palo399/SFuriel-Magnet-Press/docs/Podavace_koncepty.md

# Porovnanie podávačov magnetov

Tri rozvojové varianty používajú spoločnú zostavu lisu V1. Originál V1 zostáva zachovaný. Náhľad Porovnanie.png zobrazuje len detail mechanizmov bez rámu a dlhej rúrky, aby bol výstup viditeľný. STEP obsahuje aj rám a 300 mm zásobník.

Všetky varianty: predpokladaný magnet Ø14 × 3 mm; odber pod zásobníkom X=65, lis X=0; magnet v polohe odovzdania je v Z=17..20. Hlava musí magnet prevziať a zdvihnúť pred návratom podávača. Až potom môže lisovať. Geometria je koncepčná, bez overenia síl, plného cyklu a výrobných tolerancií.

## A – lineárny posúvač s kapsou (odporúčaný)
Zásobník plní slepú kapsu. Posúvač ide 65 mm k hlave. Jeho plná časť medzitým podopiera stĺpec; pevná stieracia doska nad posúvačom nepustí druhý magnet do dráhy. Magnet sa odoberá zhora, nad kapsou nie je pevný kryt. Model ukazuje kapsu pri hlave. Potrebné doladiť medzeru pod rúrkou podľa skutočnej hrúbky magnetu a silu oddeľovania. Jeden posuvný pohon.

## B – otočný kotúč s dvoma kapsami
Dve slepé kapsy sú proti sebe, os kotúča je X=32,5. Otočenie 180° prenesie magnet k hlave; druhá kapsa sa plní pod zásobníkom. Pevná doska pri zásobníku oddeľuje ďalší magnet. Väčší pôdorys, rotačný pohon s presným indexovaním. Potrebné preveriť okolie vodiacej lišty a rámu počas rotácie.

## C – otvorená vidlička so samostatnou uzávierkou
Vidlička nesie magnet v otvorenej kapse. Nezávislá tenká uzávierka drží zvyšok stĺpca počas odberu. Rúrka má štrbinu pre uzávierku. Dva riadené pohyby; treba dopracovať pridržiavanie stĺpca pri zasunutí uzávierky a preukázať jej zasunutie medzi magnety. Tento variant má najväčšie riziko komplikácií pri magnetickej príťažlivosti, preto je rezervný.

## Čo je a nie je overené
Overená platná geometria dielov a spätný import všetkých troch STEP zostáv. Nie je overená bezkolíznosť celého cyklu ani spoľahlivé oddelenie magnetov. Pohony a zvyšok lisu sú zatiaľ obálky z V1. Pred výrobou treba potvrdiť rozmery, polaritu a povrch magnetu, zvoliť nemagnetické materiály podávača a vyskúšať oddeľovanie reálneho stĺpca. Náhľady sú statické výkresy odvodené z CAD, nie simulácia pohybu.
