palo399/SFuriel-Magnet-Press/models/concept-C4/Mounting_holes_C4.csv

Part | Assembly_X | Assembly_Y | Diameter | Units
Base | 0 | 0 | 8 | mm
Base | -85 | -42.5 | 13 | mm
Base | 85 | -42.5 | 13 | mm
Base | -22 | 155 | 5 | mm
Base | -22 | 193 | 5 | mm
Base | 22 | 155 | 5 | mm
Base | 22 | 193 | 5 | mm
Base | 180 | -20 | 5 | mm
Base | 180 | 20 | 5 | mm
Base | 290 | -20 | 5 | mm
Base | 290 | 20 | 5 | mm
Base | -19 | -100 | 6.6 | mm
Base | -19 | 50 | 6.6 | mm
Base | 19 | -100 | 6.6 | mm
Base | 19 | 50 | 6.6 | mm
Base | -130 | -140 | 9 | mm
Base | -130 | 230 | 9 | mm
Base | 340 | -140 | 9 | mm
Base | 340 | 230 | 9 | mm
Bridge | -85 | -42.5 | 13 | mm
Bridge | 85 | -42.5 | 13 | mm
Bridge | 0 | 0 | 20 | mm
Bridge | 65 | 0 | 20.5 | mm
Bridge | -23.25 | -23.25 | 9 | mm
Bridge | -23.25 | 23.25 | 9 | mm
Bridge | 23.25 | -23.25 | 9 | mm
Bridge | 23.25 | 23.25 | 9 | mm
Bridge | 52 | -13 | 4.5 | mm
Bridge | 52 | 13 | 4.5 | mm
Bridge | 78 | -13 | 4.5 | mm
Bridge | 78 | 13 | 4.5 | mm
