palo399/SFuriel-Magnet-Press/models/concept-C2/Track_C2.png

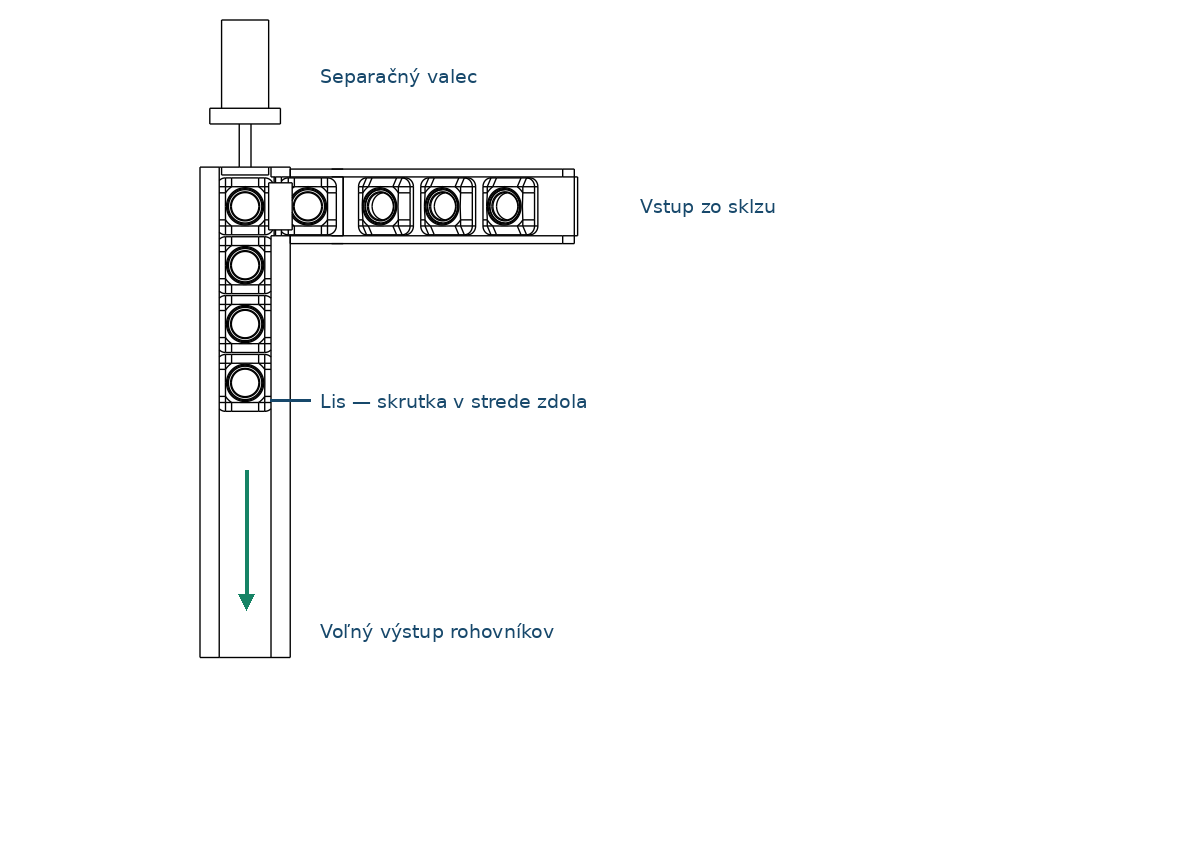
models/concept-C2/Track_C2.png
