palo399/SFuriel-Magnet-Press/models/concept-C4/Plan_C4.png

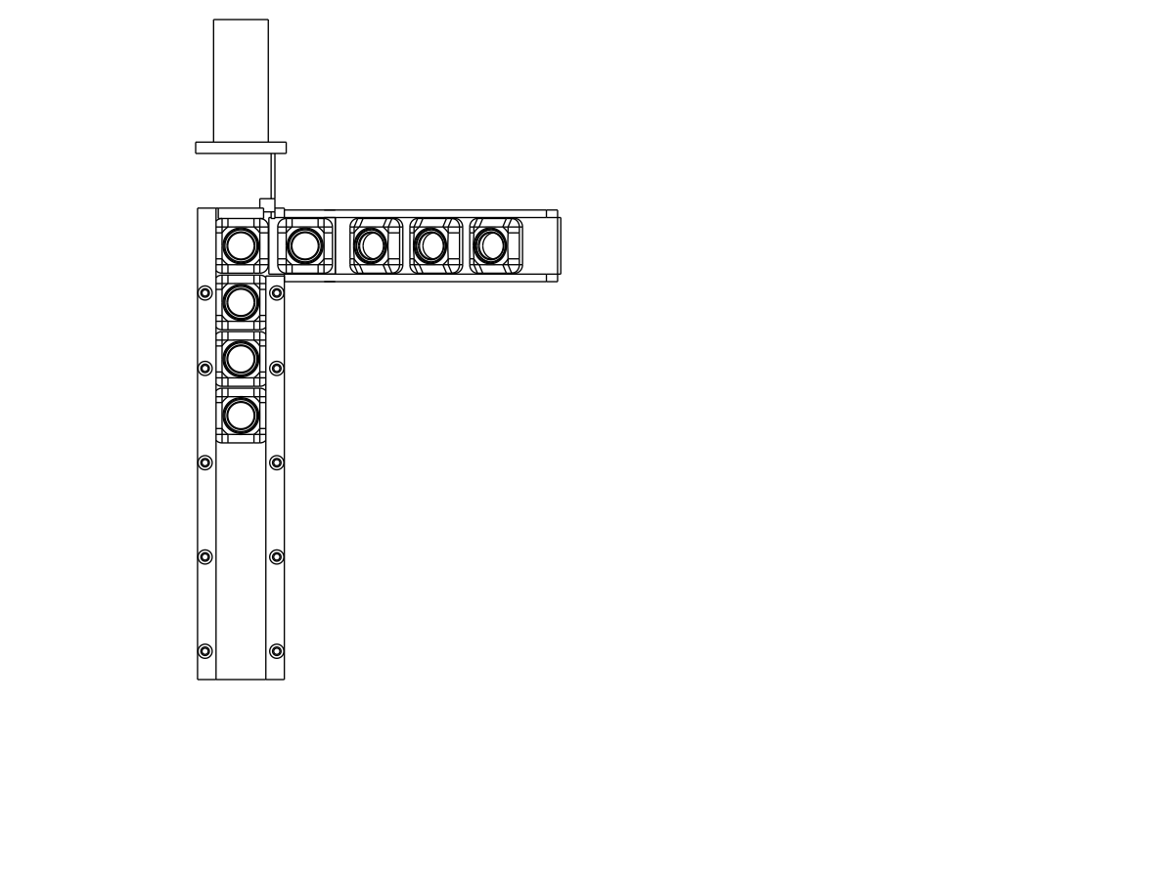
models/concept-C4/Plan_C4.png
