palo399/SFuriel-Magnet-Press/models/feeder-concepts/A_linear.png

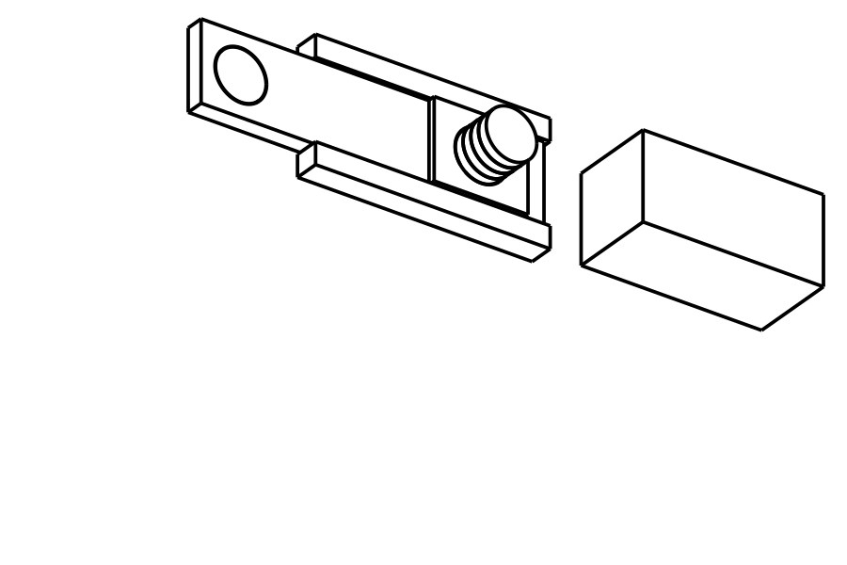
models/feeder-concepts/A_linear.png
