palo399/SFuriel-Magnet-Press/models/feeder-concepts/B_rotary.png

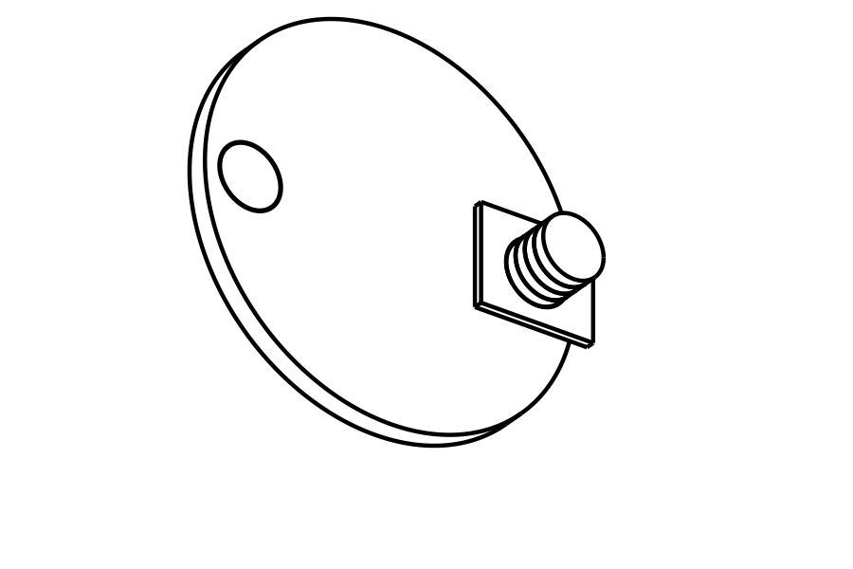
models/feeder-concepts/B_rotary.png
