palo399/SFuriel-Magnet-Press/models/feeder-concepts/C_fork.png

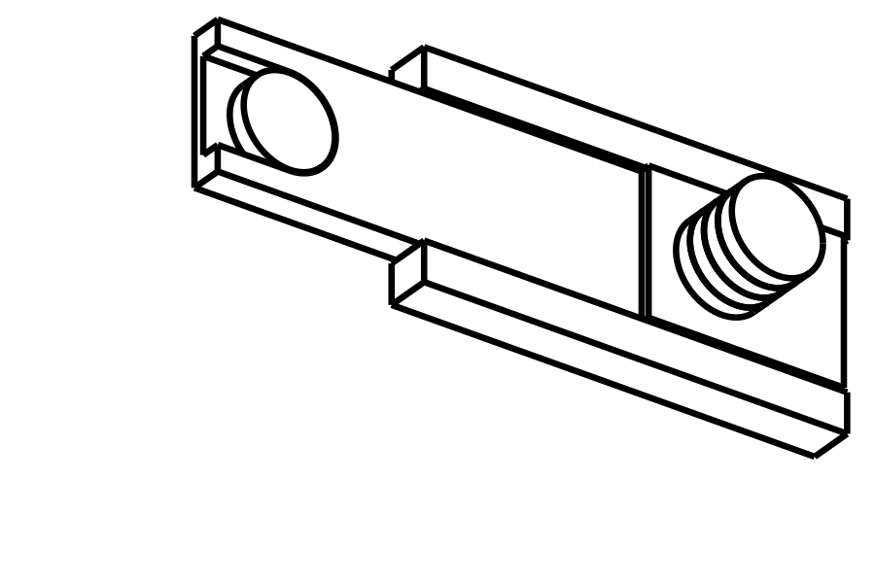
models/feeder-concepts/C_fork.png
