palo399/SFuriel-Magnet-Press/models/feeder-concepts/Porovnanie.png

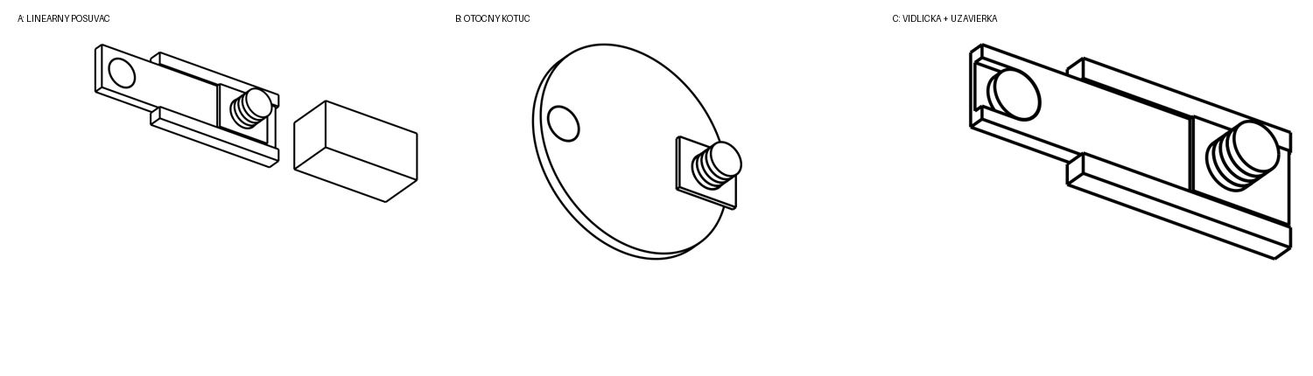
models/feeder-concepts/Porovnanie.png
