palo399/SFuriel-Magnet-Press/models/concept-C2/C_fork.step

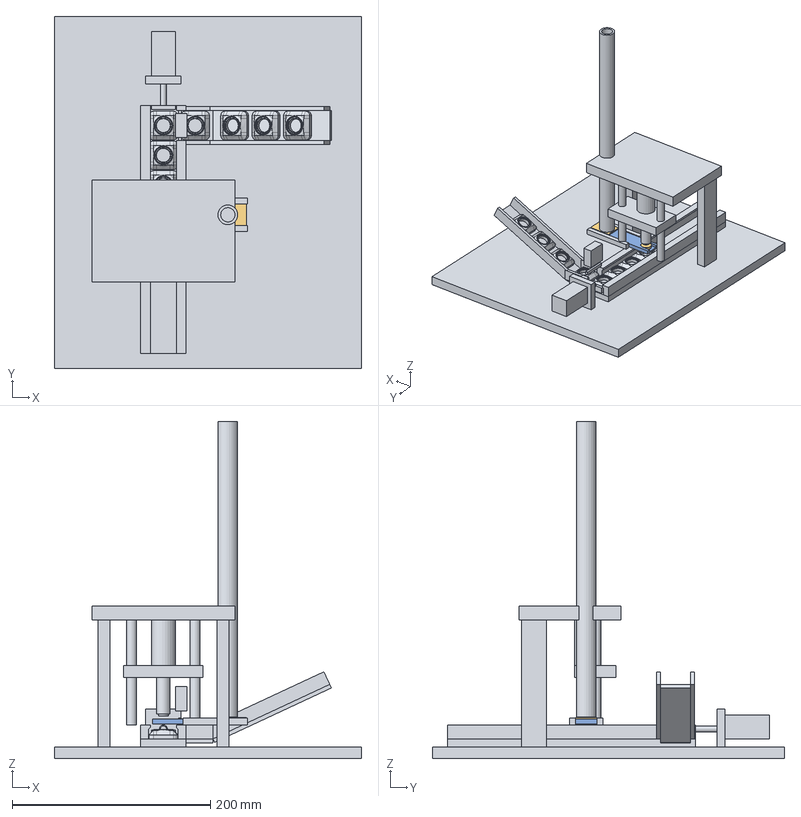
[picture p8: CAD file, 2026-10-31]
models/concept-C2/C_fork.step
310.0 x 355.0 x 340.2 mm
Guide_post_-32
Guide_post_32
Moving_crosshead
Press_ram_envelope
Press_punch
Head_pickup_magnet
Workpiece_at_press_C2
M6_vertical_plunger_body_envelope
Plunger_ball_concept
Base_C2
Side_frame_column_-66
Side_frame_column_54
Top_bridge_C2
Through_track_bed
Left_through_retaining_rail
Right_through_retaining_rail
L_inlet_level_bed
L_inlet_level_side_71
L_inlet_level_side_105
Chute_bed
Chute_wall_front
Chute_wall_back
Queue_on_track_0
Queue_on_track_1
Queue_on_track_2
Part_at_lateral_inlet
Part_on_inlet_slope_0
Part_on_inlet_slope_1
Part_on_inlet_slope_2
Separator_cylinder_body_envelope
Separator_cylinder_mount
Separator_rod_retracted
Separator_pusher_retracted
Inlet_gate_blade_open
Inlet_gate_actuator_envelope
Pickup_magnet
Open_fork
Independent_stack_gate_closed
Tube_with_gate_slot
Fork_guide_-17
Fork_guide_11
Stack_magnet_0
Stack_magnet_1
Stack_magnet_2
Stack_magnet_3
