palo399/SFuriel-Magnet-Press/models/concept-C3/plates/P08_Mast_shelf_50.step

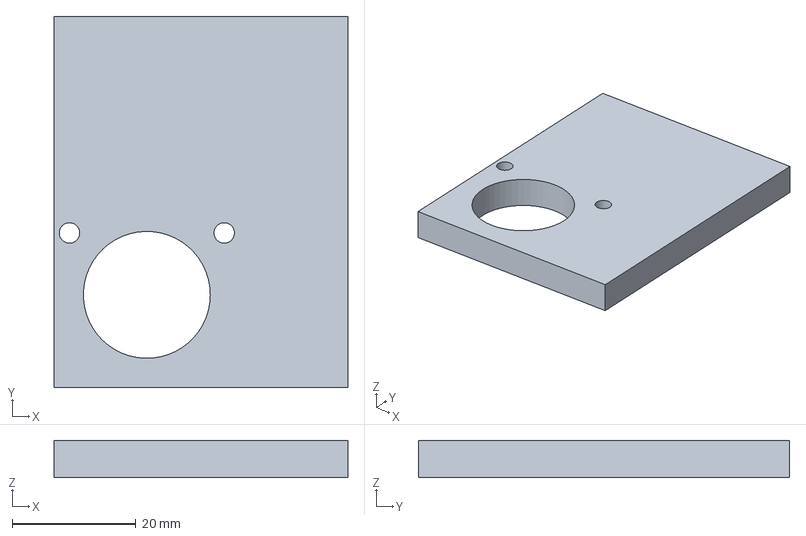
[picture p9: CAD file, 2026-10-31]
models/concept-C3/plates/P08_Mast_shelf_50.step
47.5 x 60.0 x 6.00 mm
