palo399/SFuriel-Magnet-Press/models/concept-C3/Rohovnik_press_C3_Bosch_Festo.step

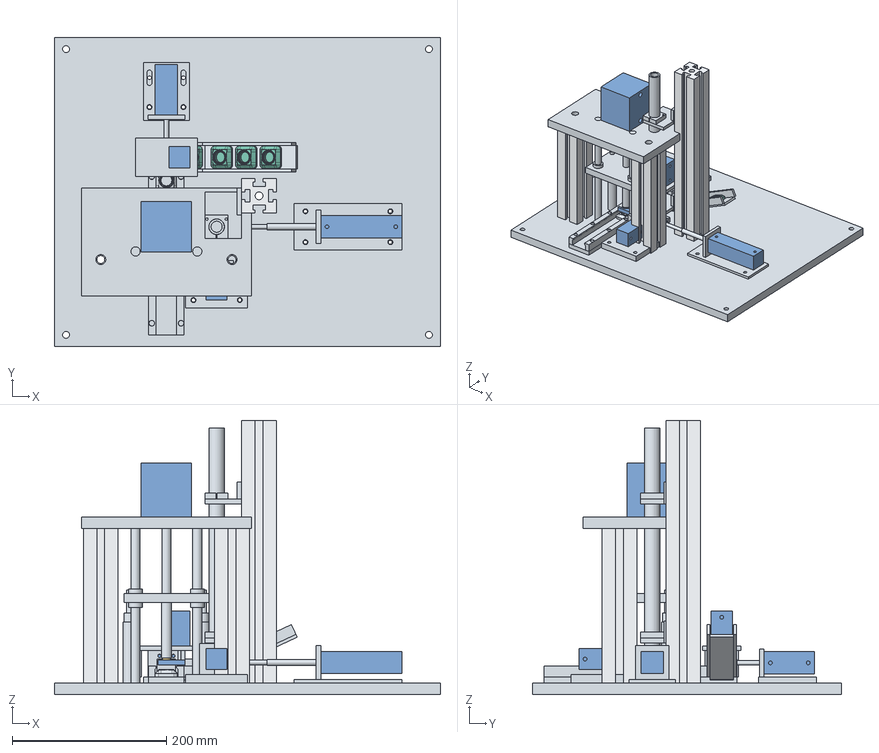
[picture p10: CAD file, 2026-10-31]
models/concept-C3/Rohovnik_press_C3_Bosch_Festo.step
500.0 x 400.0 x 355.0 mm
Workpiece_at_press_C2
M6_vertical_plunger_body_envelope
Plunger_ball_concept
L_inlet_level_bed
L_inlet_level_side_71
L_inlet_level_side_105
Chute_bed
Chute_wall_front
Chute_wall_back
Queue_on_track_0
Queue_on_track_1
Queue_on_track_2
Part_at_lateral_inlet
Part_on_inlet_slope_0
Part_on_inlet_slope_1
Part_on_inlet_slope_2
P01_Base
P02_Track_bed
M4x16_Left_-125
M4x16_Left_-75
M4x16_Left_-25
M4x16_Left_25
M4x16_Left_65
Left_through_retaining_rail
M4x16_Righ_-125
M4x16_Righ_-75
M4x16_Righ_-25
M4x16_Righ_25
M4x16_Righ_65
Right_through_retaining_rail
BR_Left_column
BR_Right_column
BR_Magazine_mast
P03_Top_bridge
P04_Moving_head
Guide_D12_-40
Guide_bushing_-40
Guide_D12_40
Guide_bushing_40
Punch_shaft
Head_pickup_magnet
Product_magnet_14x5
Stop_support_-48
Adjustable_stop_M8_-48
Stop_support_48
Adjustable_stop_M8_48
Festo_PRESS_ADN50_25
Press_rod_adapter
Festo_PART_INDEX_ADN16_30
P05_Separator_face
Separator_rod_extension
Separator_pusher
P06_Separator_foot
C_fork_14x5
Fork_slide_guide_-17
Fork_slide_guide_11
Festo_FORK_ADN16_70
P07_Fork_motor_face
Fork_link_extension
Fork_extended_rod_65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
