palo399/SFuriel-Magnet-Press/models/concept-C4/C4_Bridge.step

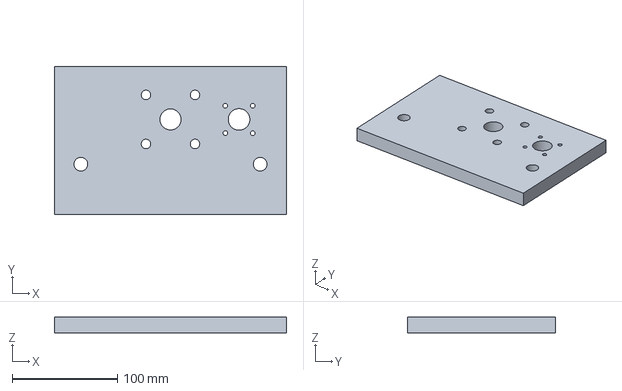
[picture p11: CAD file, 2026-10-31]
models/concept-C4/C4_Bridge.step
220.0 x 140.0 x 15.0 mm
