palo399/SFuriel-Magnet-Press/models/feeder-concepts/C_fork.step

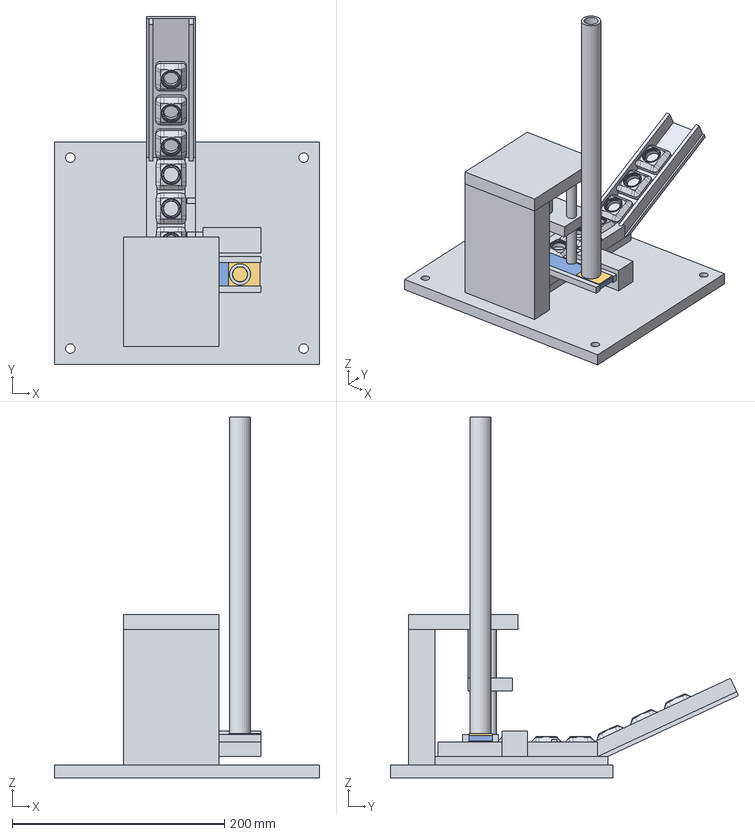
[picture p13: CAD file, 2026-10-31]
models/feeder-concepts/C_fork.step
250.0 x 328.1 x 340.2 mm
Base_plate
Track_support
Workpiece_at_press
Left_retaining_bevel_rail
Right_retaining_bevel_rail
Gravity_chute_25deg
Chute_side_L
Chute_side_R
Queued_part_1
Queued_part_2
Queued_part_3
Chute_part_1
Chute_part_2
Chute_part_3
Part_index_cylinder_envelope
Part_index_slide
Escapement_stop_35
Escapement_stop_67
Station_end_stop
M6_ball_plunger_envelope
Plunger_ball
Rear_column
Top_crossmember
Guide_post_-32
Guide_post_32
Moving_crosshead
Press_ram_envelope
Press_punch
Head_pickup_magnet
Pickup_magnet
Open_fork
Independent_stack_gate_closed
Tube_with_gate_slot
Fork_guide_-17
Fork_guide_11
Stack_magnet_0
Stack_magnet_1
Stack_magnet_2
Stack_magnet_3
