palo399/SFuriel-Magnet-Press/models/manufacturing-C5/parts/D10_Fixed_stripper.step

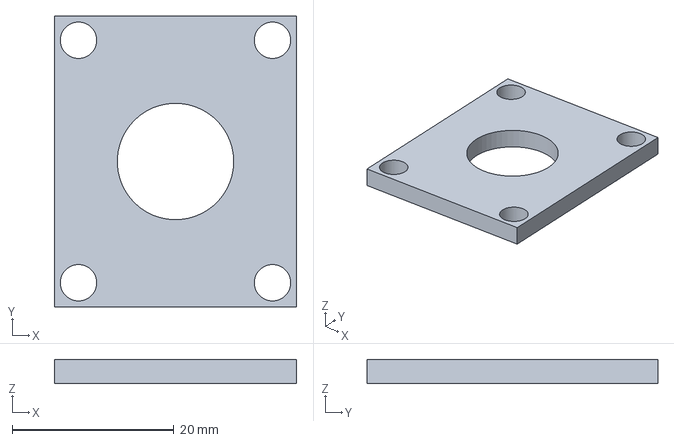
[picture p14: CAD file, 2026-10-31]
models/manufacturing-C5/parts/D10_Fixed_stripper.step
30.0 x 36.0 x 3.00 mm
