palo399/SFuriel-Magnet-Press/models/manufacturing-C5/Rohovnik_press_C5_prototype_DRAFT.step

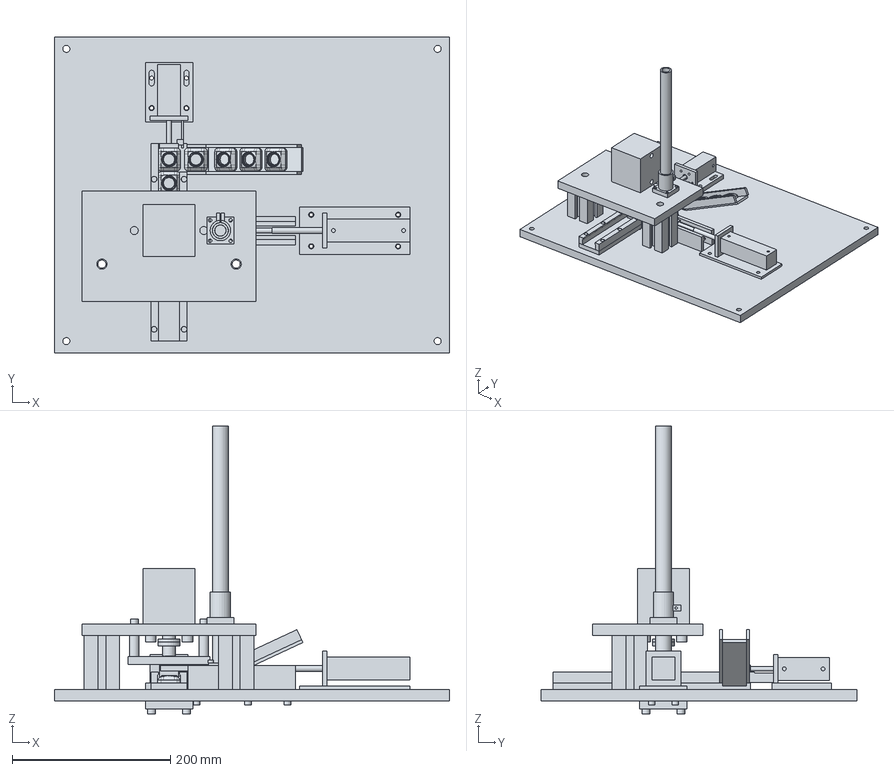
[picture p15: CAD file, 2026-10-31]
models/manufacturing-C5/Rohovnik_press_C5_prototype_DRAFT.step
500.0 x 400.0 x 364.2 mm
Workpiece_at_press_C2
L_inlet_level_bed
L_inlet_level_side_71
L_inlet_level_side_105
Chute_bed
Chute_wall_front
Chute_wall_back
Queue_on_track_0
Queue_on_track_1
Queue_on_track_2
Part_on_inlet_slope_0
Part_on_inlet_slope_1
Part_on_inlet_slope_2
M4x16_Left_-125
M4x16_Left_-75
M4x16_Left_-25
M4x16_Left_25
M4x16_Left_65
Left_through_retaining_rail
M4x16_Righ_-125
M4x16_Righ_-75
M4x16_Righ_-25
M4x16_Righ_25
M4x16_Righ_65
Right_through_retaining_rail
Head_pickup_magnet
Product_magnet_14x5
Festo_PART_INDEX_ADN16_30
P05_Separator_face
Separator_rod_extension
P06_Separator_foot
Festo_FORK_ADN16_70
P07_Fork_motor_face
Fork_link_extension
Fork_extended_rod_65
P09_Fork_motor_foot
Next_rohovnik_on_inlet
BR_Left_column_L68
BR_Right_column_L68
Festo_PRESS_ADN50_25
Magnet_tube_300
Stack_14x5_0
Stack_14x5_1
Stack_14x5_2
Stack_14x5_3
Linked_pusher_and_inlet_shutter
KIPP_K0309_212_ORIGINAL
D01_Base
D02_Track_bed
D03_Plunger_block
D04_Bridge
D05_Stop_plate
D06_Stop_spacer_-44
D06_Stop_spacer_44
D07_Press_tool
D08_Adjust_ring
D09_Lock_ring
D10_Fixed_stripper
D11_Carrier_support_-18
D11_Carrier_support_12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
