palo399/SFuriel-Magnet-Press/models/Rohovnik magnet.stp

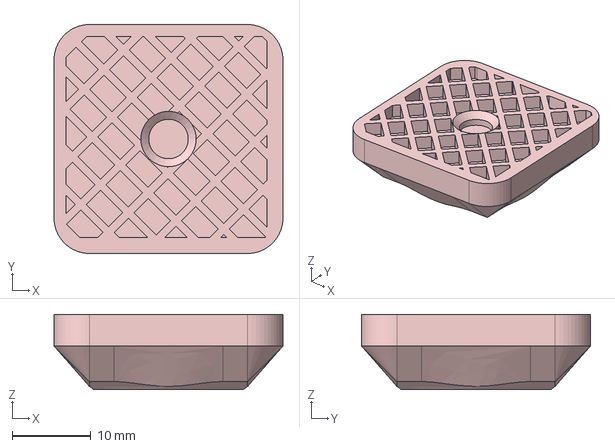
[picture p16: CAD file, 2026-10-31]
models/Rohovnik magnet.stp
29.0 x 29.0 x 9.50 mm
