palo399/SFuriel-Magnet-Press/models/concept-C3/plates/Right_through_retaining_rail.step

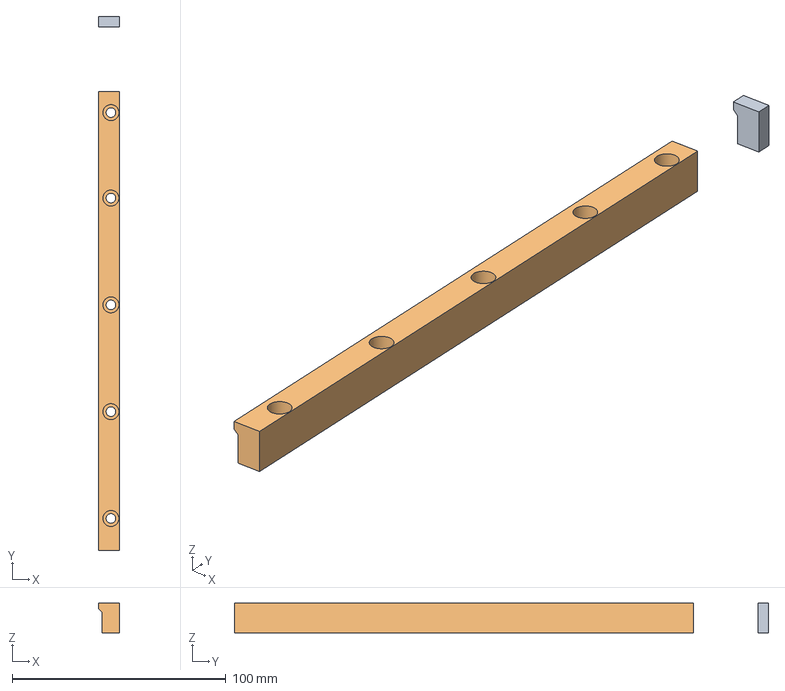
[picture p17: CAD file, 2026-10-31]
models/concept-C3/plates/Right_through_retaining_rail.step
9.80 x 250.0 x 14.0 mm
