palo399/SFuriel-Magnet-Press/models/concept-C4/Fixed_magnet_stripper.step

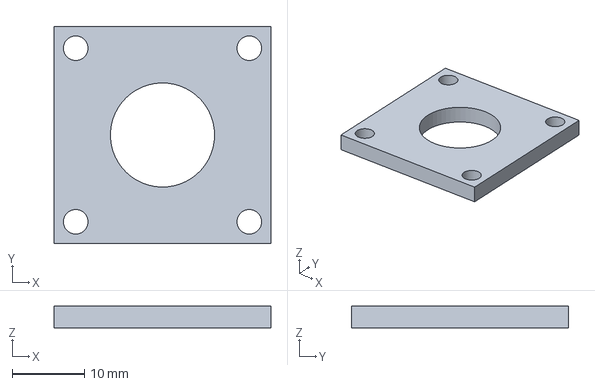
[picture p18: CAD file, 2026-10-31]
models/concept-C4/Fixed_magnet_stripper.step
30.0 x 30.0 x 3.00 mm
