palo399/SFuriel-Magnet-Press/models/manufacturing-C5/parts/D12_Carrier_14x5.step

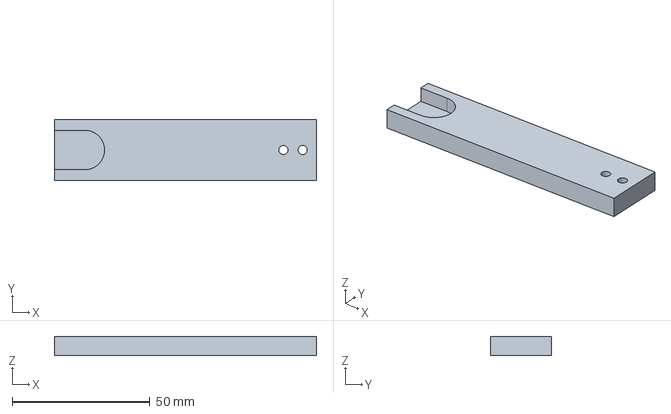
[picture p19: CAD file, 2026-10-31]
models/manufacturing-C5/parts/D12_Carrier_14x5.step
95.0 x 22.0 x 7.00 mm
