palo399/SFuriel-Magnet-Press/models/concept-C3/plates/P04_Moving_head.step

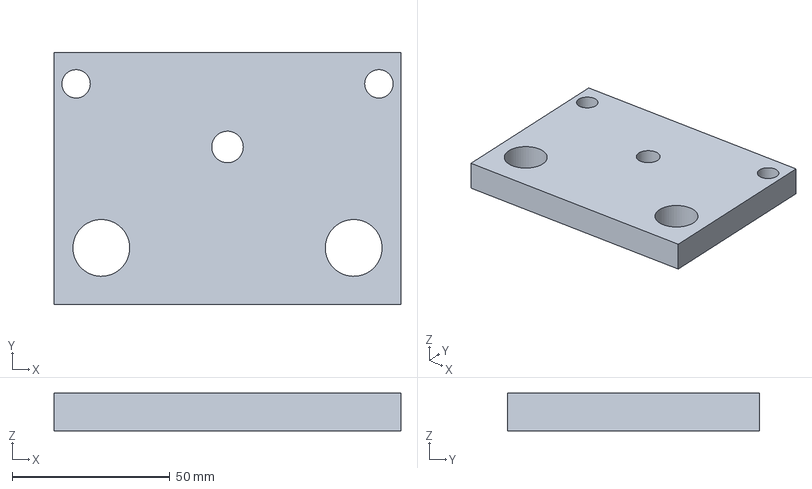
[picture p20: CAD file, 2026-10-31]
models/concept-C3/plates/P04_Moving_head.step
110.0 x 80.0 x 12.0 mm
