palo399/SFuriel-Magnet-Press/models/concept-C4/Rohovnik_press_C4_simple.step

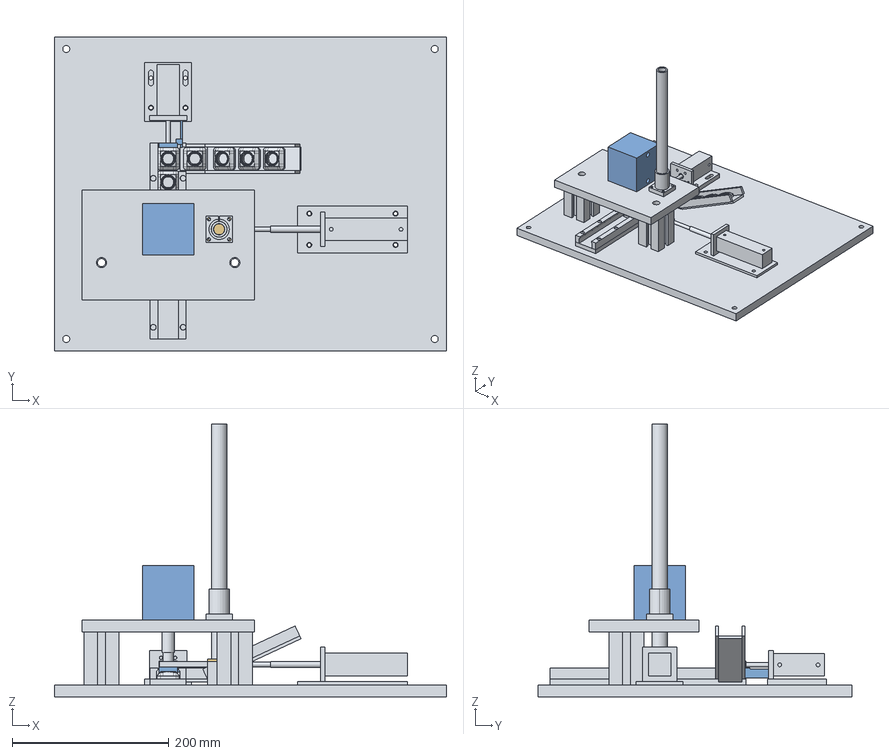
[picture p21: CAD file, 2026-10-31]
models/concept-C4/Rohovnik_press_C4_simple.step
500.0 x 400.0 x 348.2 mm
Workpiece_at_press_C2
M6_vertical_plunger_body_envelope
Plunger_ball_concept
L_inlet_level_bed
L_inlet_level_side_71
L_inlet_level_side_105
Chute_bed
Chute_wall_front
Chute_wall_back
Queue_on_track_0
Queue_on_track_1
Queue_on_track_2
Part_on_inlet_slope_0
Part_on_inlet_slope_1
Part_on_inlet_slope_2
P02_Track_bed
M4x16_Left_-125
M4x16_Left_-75
M4x16_Left_-25
M4x16_Left_25
M4x16_Left_65
Left_through_retaining_rail
M4x16_Righ_-125
M4x16_Righ_-75
M4x16_Righ_-25
M4x16_Righ_25
M4x16_Righ_65
Right_through_retaining_rail
Head_pickup_magnet
Product_magnet_14x5
Festo_PART_INDEX_ADN16_30
P05_Separator_face
Separator_rod_extension
P06_Separator_foot
C_fork_14x5
Festo_FORK_ADN16_70
P07_Fork_motor_face
Fork_link_extension
Fork_extended_rod_65
Fork_coupling_block
P09_Fork_motor_foot
Next_rohovnik_on_inlet
C4_Base_plate
BR_Left_column_L68
BR_Right_column_L68
C4_Bridge
Festo_PRESS_ADN50_25
Short_coaxial_press_tool
Fixed_magnet_stripper
Stripper_side_support_-15
Stripper_side_support_12
Magnet_tube_300
Tube_split_collar_on_bridge
Stack_14x5_0
Stack_14x5_1
Stack_14x5_2
Stack_14x5_3
Linked_pusher_and_inlet_shutter
