palo399/SFuriel-Magnet-Press/models/manufacturing-C5/parts/D14_Tube_collar.step

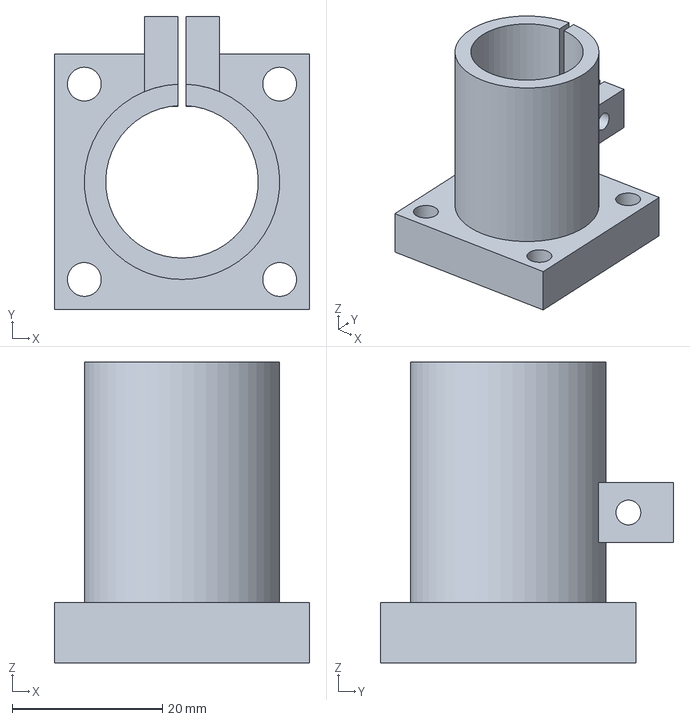
[picture p23: CAD file, 2026-10-31]
models/manufacturing-C5/parts/D14_Tube_collar.step
34.0 x 39.0 x 40.0 mm
