palo399/SFuriel-Magnet-Press/models/concept-C3/plates/P02_Track_bed.step

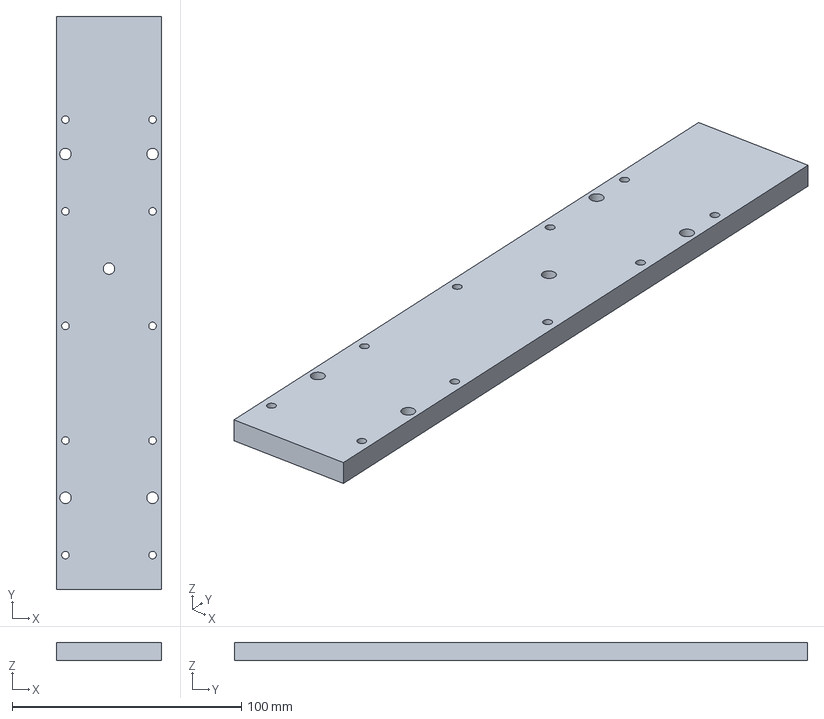
[picture p24: CAD file, 2026-10-31]
models/concept-C3/plates/P02_Track_bed.step
46.0 x 250.0 x 8.00 mm
