palo399/SFuriel-Magnet-Press/models/concept-C4/Linked_pusher_and_inlet_shutter.step

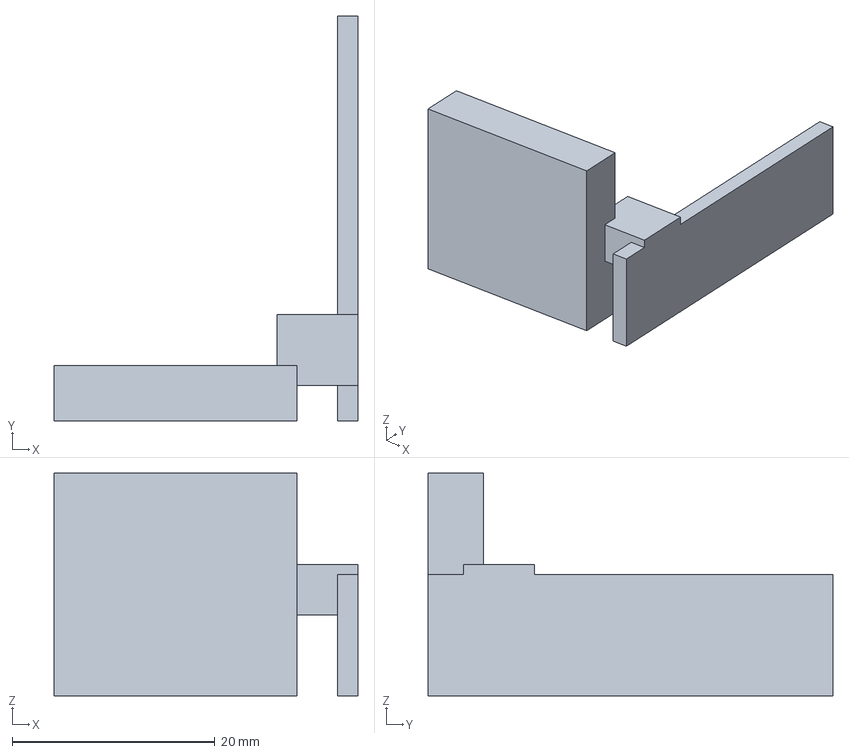
[picture p25: CAD file, 2026-10-31]
models/concept-C4/Linked_pusher_and_inlet_shutter.step
30.0 x 40.0 x 22.0 mm
