palo399/SFuriel-Magnet-Press/models/manufacturing-C5/parts/D11_Carrier_support_12.step

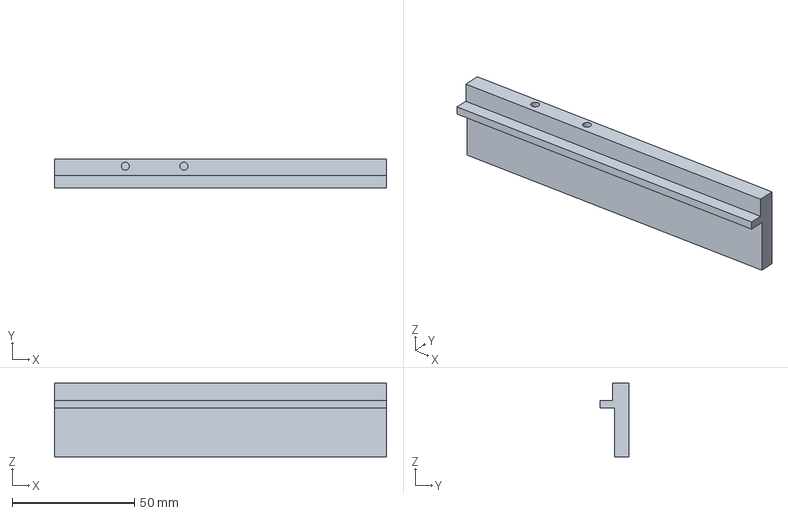
[picture p26: CAD file, 2026-10-31]
models/manufacturing-C5/parts/D11_Carrier_support_12.step
136.0 x 12.0 x 30.2 mm
