palo399/SFuriel-Magnet-Press/models/concept-C3/plates/P09_Fork_motor_foot.step

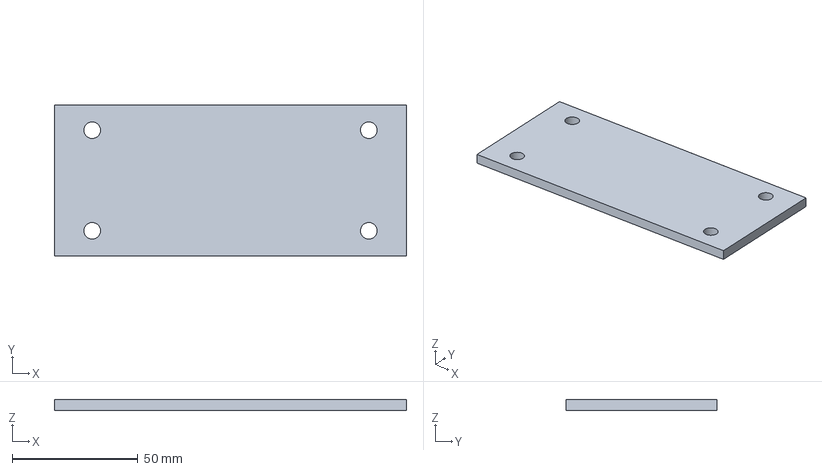
[picture p27: CAD file, 2026-10-31]
models/concept-C3/plates/P09_Fork_motor_foot.step
140.0 x 60.0 x 4.50 mm
