palo399/SFuriel-Magnet-Press/models/concept-C4/Short_coaxial_press_tool.step

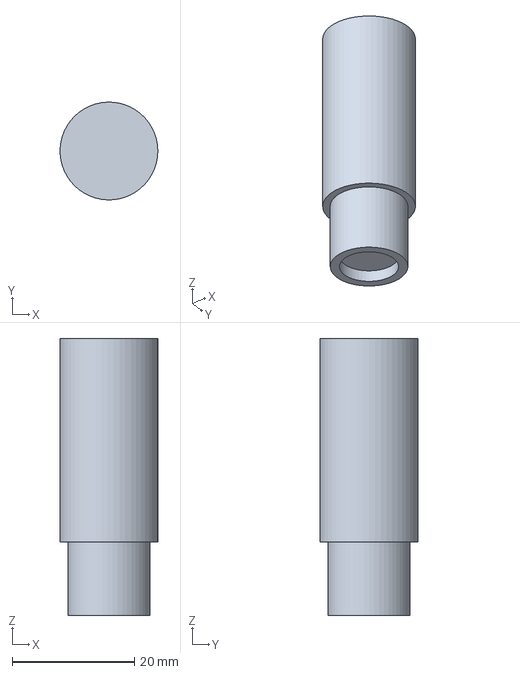
[picture p28: CAD file, 2026-10-31]
models/concept-C4/Short_coaxial_press_tool.step
16.0 x 16.0 x 45.3 mm
