palo399/SFuriel-Magnet-Press/models/manufacturing-C5/parts/D05_Stop_plate.step

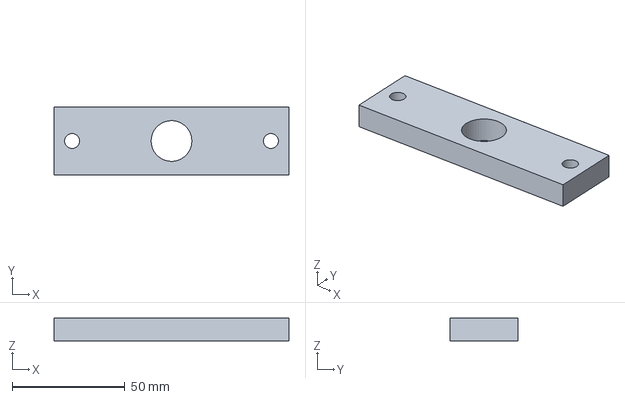
[picture p29: CAD file, 2026-10-31]
models/manufacturing-C5/parts/D05_Stop_plate.step
104.0 x 30.0 x 10.0 mm
