palo399/SFuriel-Magnet-Press/models/concept-C3/plates/P11_Inlet_gate_motor_shelf.step

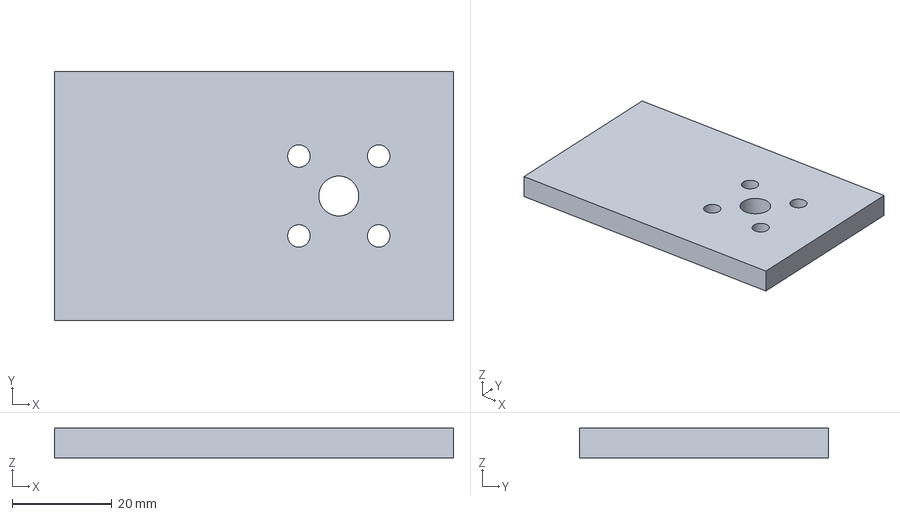
[picture p30: CAD file, 2026-10-31]
models/concept-C3/plates/P11_Inlet_gate_motor_shelf.step
80.0 x 50.0 x 6.00 mm
