palo399/SFuriel-Magnet-Press/models/concept-C4/Tube_split_collar_on_bridge.step

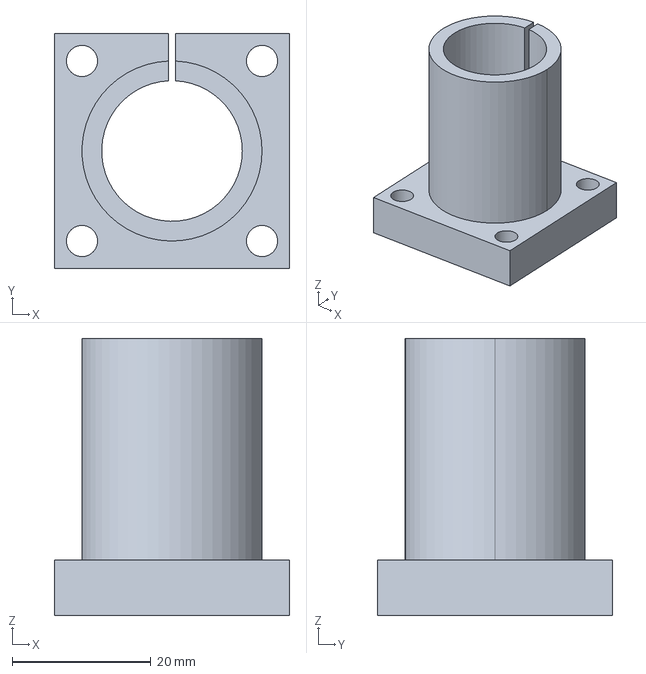
[picture p31: CAD file, 2026-10-31]
models/concept-C4/Tube_split_collar_on_bridge.step
34.0 x 34.0 x 40.0 mm
