palo399/SFuriel-Magnet-Press/models/manufacturing-C5/parts/D07_Press_tool.step

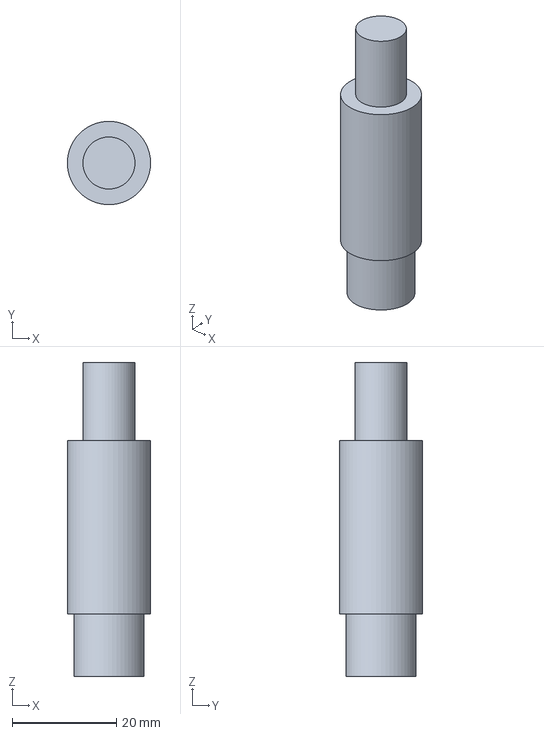
[picture p32: CAD file, 2026-10-31]
models/manufacturing-C5/parts/D07_Press_tool.step
16.0 x 16.0 x 60.3 mm
