palo399/SFuriel-Magnet-Press/models/concept-C3/plates/Left_through_retaining_rail.step

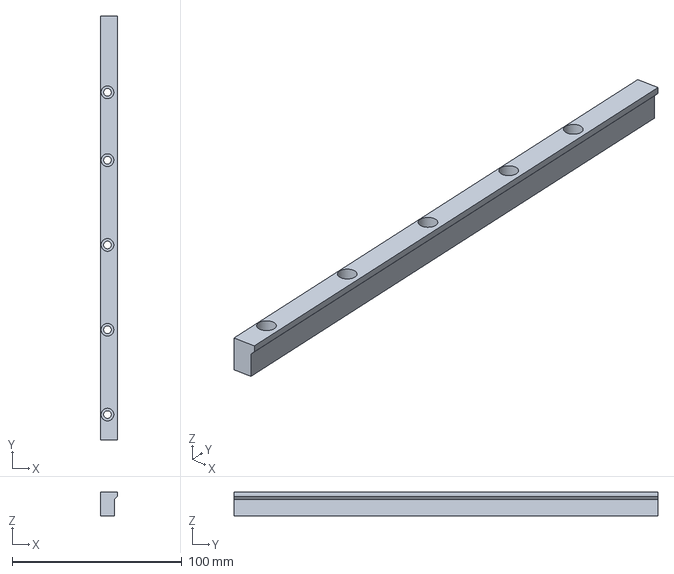
[picture p33: CAD file, 2026-10-31]
models/concept-C3/plates/Left_through_retaining_rail.step
9.80 x 250.0 x 14.0 mm
