palo399/SFuriel-Magnet-Press/models/concept-C4/C4_Base_plate.step

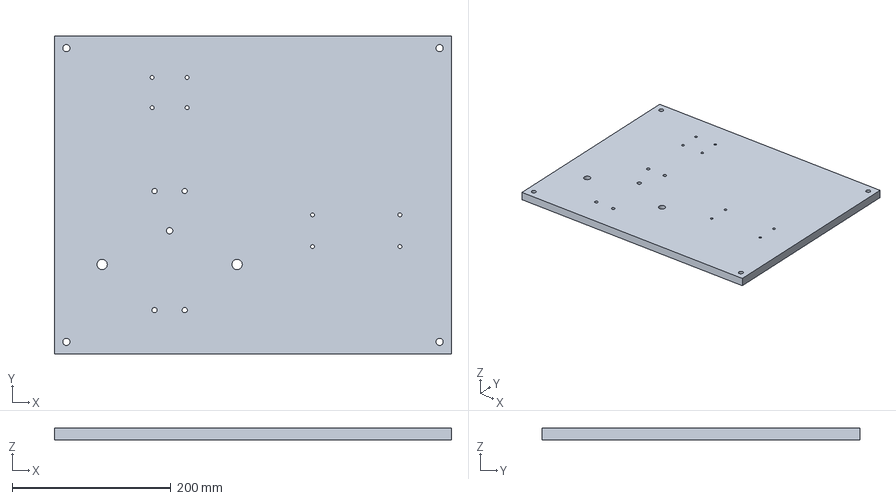
[picture p34: CAD file, 2026-10-31]
models/concept-C4/C4_Base_plate.step
500.0 x 400.0 x 15.0 mm
