palo399/SFuriel-Magnet-Press/models/concept-C3/plates/P03_Top_bridge.step

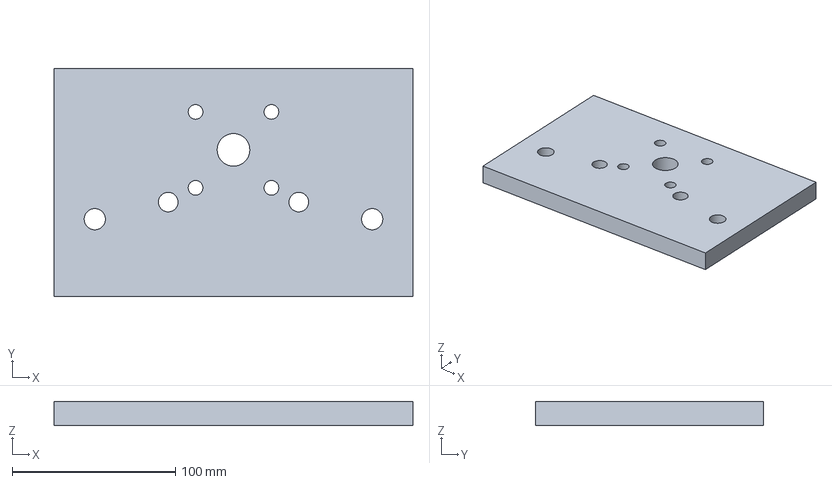
[picture p35: CAD file, 2026-10-31]
models/concept-C3/plates/P03_Top_bridge.step
220.0 x 140.0 x 15.0 mm
