palo399/SFuriel-Magnet-Press/models/manufacturing-C5/parts/D03_Plunger_block.step

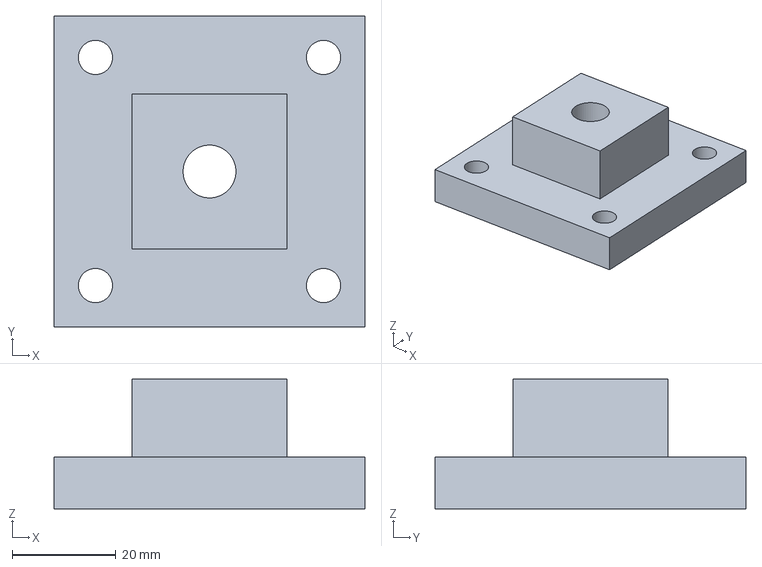
[picture p36: CAD file, 2026-10-31]
models/manufacturing-C5/parts/D03_Plunger_block.step
60.0 x 60.0 x 25.0 mm
