palo399/SFuriel-Magnet-Press/models/concept-C3/plates/P05_Separator_face.step

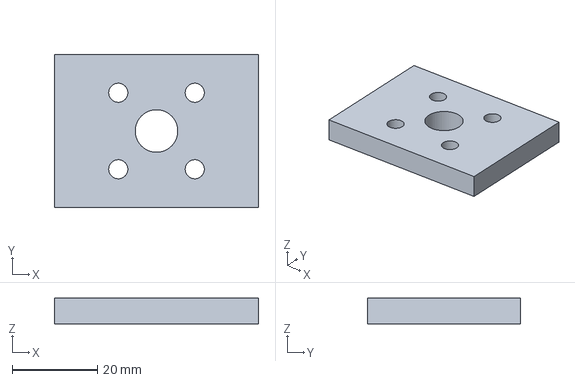
[picture p37: CAD file, 2026-10-31]
models/concept-C3/plates/P05_Separator_face.step
48.0 x 36.0 x 6.00 mm
