palo399/SFuriel-Magnet-Press/models/manufacturing-C5/parts/D13_Under_carrier_link.step

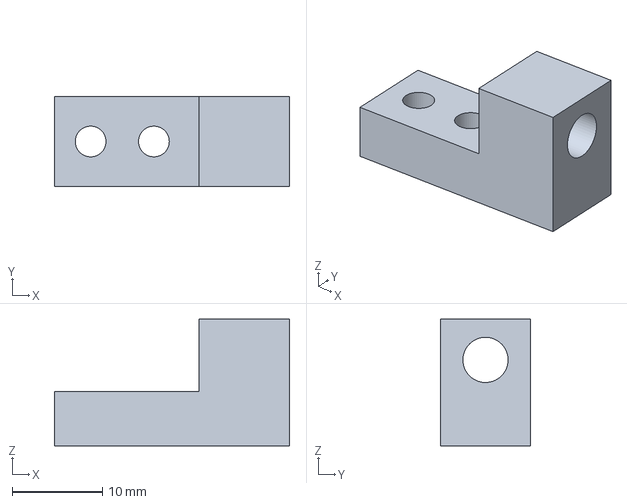
[picture p38: CAD file, 2026-10-31]
models/manufacturing-C5/parts/D13_Under_carrier_link.step
26.0 x 10.0 x 14.0 mm
