palo399/SFuriel-Magnet-Press/models/concept-C3/plates/P12_Magnet_gate_foot.step

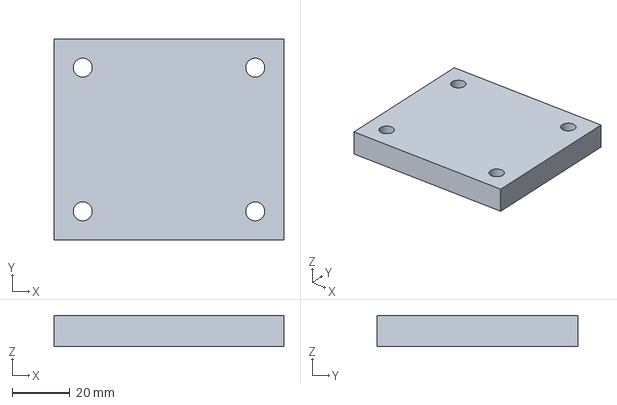
[picture p39: CAD file, 2026-10-31]
models/concept-C3/plates/P12_Magnet_gate_foot.step
80.0 x 70.0 x 10.9 mm
