palo399/SFuriel-Magnet-Press/models/manufacturing-C5/parts/D09_Lock_ring.step

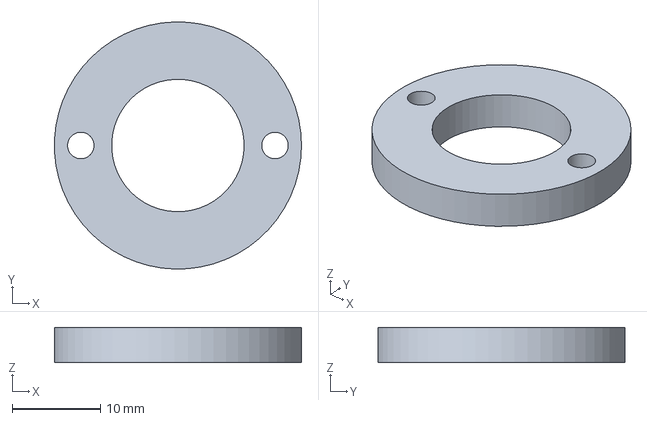
[picture p40: CAD file, 2026-10-31]
models/manufacturing-C5/parts/D09_Lock_ring.step
28.0 x 28.0 x 4.00 mm
