palo399/SFuriel-Magnet-Press/models/concept-C3/plates/P06_Separator_foot.step

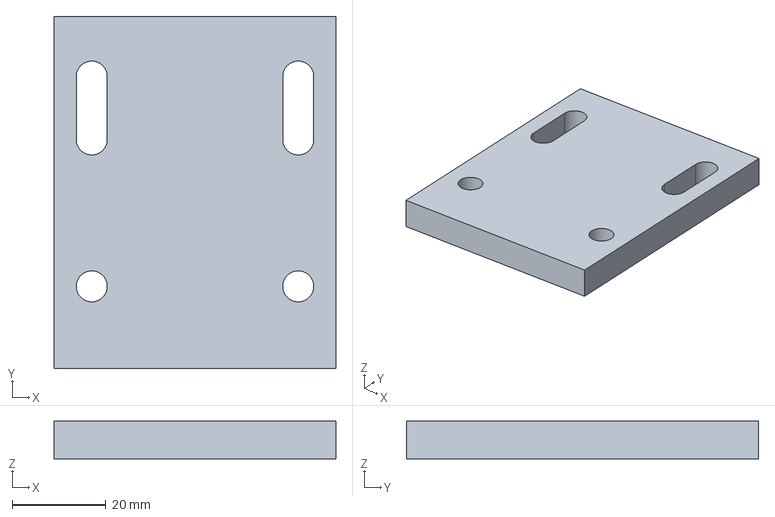
[picture p41: CAD file, 2026-10-31]
models/concept-C3/plates/P06_Separator_foot.step
60.0 x 75.0 x 8.00 mm
