palo399/SFuriel-Magnet-Press/models/concept-C3/plates/P07_Fork_motor_face_local.step

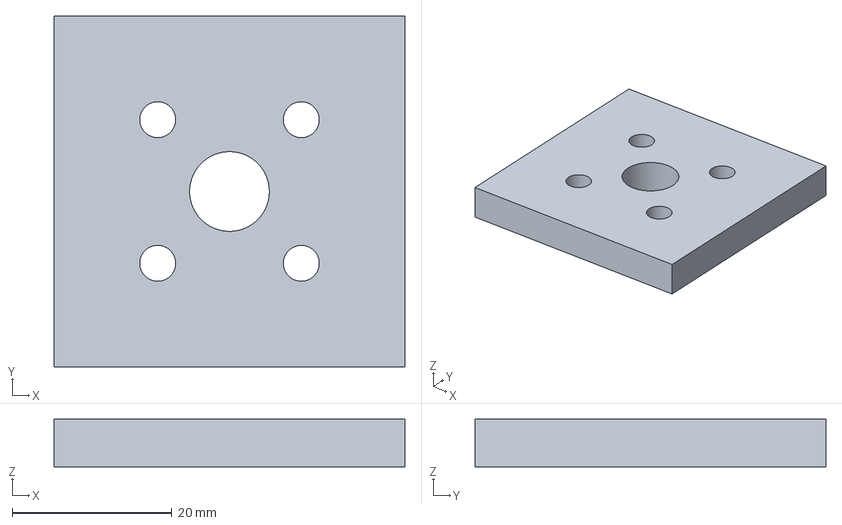
[picture p42: CAD file, 2026-10-31]
models/concept-C3/plates/P07_Fork_motor_face_local.step
44.0 x 44.0 x 6.00 mm
