palo399/SFuriel-Magnet-Press/models/manufacturing-C5/parts/D06_Stop_spacer_-44.step

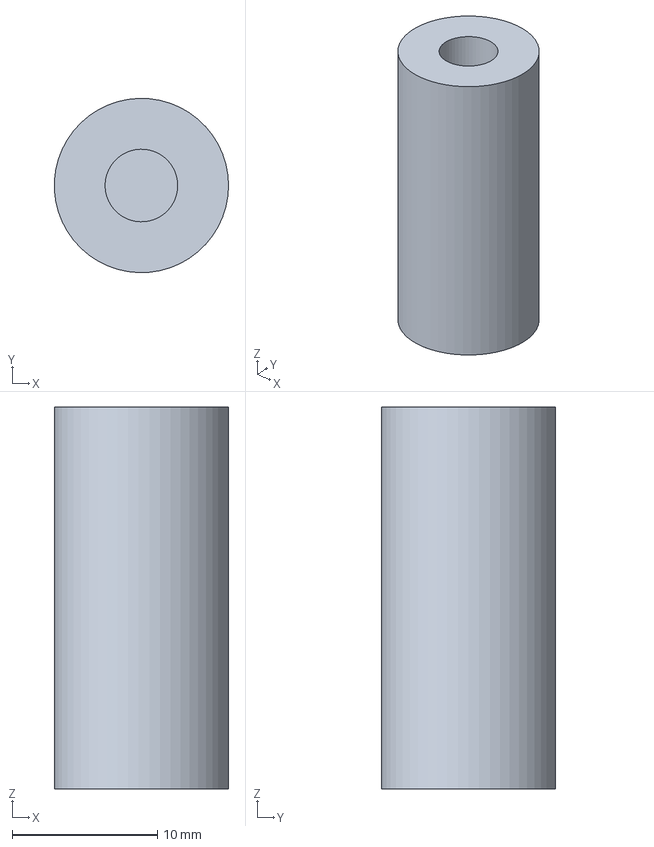
[picture p43: CAD file, 2026-10-31]
models/manufacturing-C5/parts/D06_Stop_spacer_-44.step
12.0 x 12.0 x 26.3 mm
