palo399/SFuriel-Magnet-Press/models/concept-C3/plates/P10_Magnet_gate_face.step

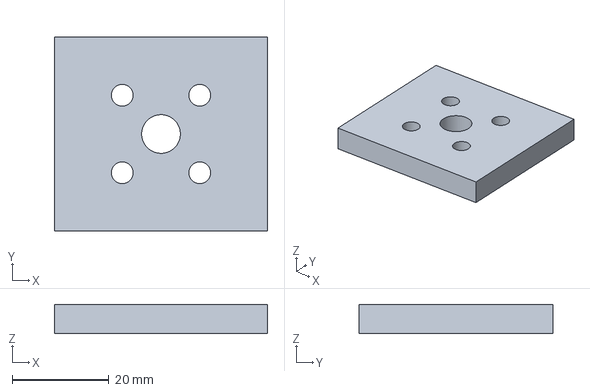
[picture p44: CAD file, 2026-10-31]
models/concept-C3/plates/P10_Magnet_gate_face.step
44.0 x 40.0 x 6.00 mm
