palo399/SFuriel-Magnet-Press/models/manufacturing-C5/parts/D08_Adjust_ring.step

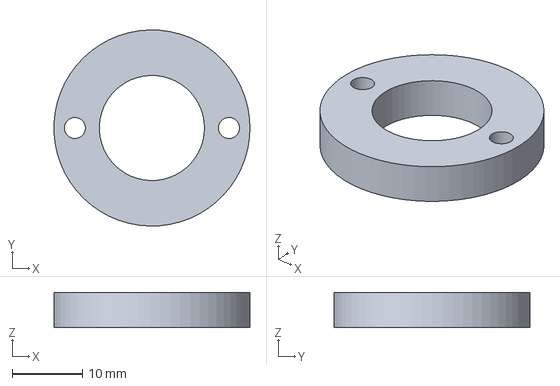
[picture p45: CAD file, 2026-10-31]
models/manufacturing-C5/parts/D08_Adjust_ring.step
28.0 x 28.0 x 5.00 mm
