palo399/SFuriel-Magnet-Press/(list of files, cad)

Other CAD files:
models/feeder-concepts/B_rotary.step
models/manufacturing-C5/parts/D02_Track_bed.step
models/manufacturing-C5/parts/D11_Carrier_support_-18.step
models/concept-C3/plates/P08_Mast_shelf_230.step
models/manufacturing-C5/parts/D04_Bridge.step
models/concept-C3/plates/P01_Base.step
models/manufacturing-C5/parts/D01_Base.step
models/concept-C3/plates/P01_Base.dxf
models/concept-C3/plates/P02_Track_bed.dxf
models/concept-C3/plates/P03_Top_bridge.dxf
models/concept-C3/plates/P04_Moving_head.dxf
models/concept-C3/plates/P05_Separator_face.dxf
models/concept-C3/plates/P06_Separator_foot.dxf
models/concept-C3/plates/P07_Fork_motor_face_local.dxf
models/concept-C3/plates/P08_Mast_shelf_230.dxf
models/concept-C3/plates/P08_Mast_shelf_50.dxf
models/concept-C3/plates/P09_Fork_motor_foot.dxf
models/concept-C3/plates/P10_Magnet_gate_face.dxf
models/concept-C3/plates/P11_Inlet_gate_motor_shelf.dxf
models/concept-C3/plates/P12_Magnet_gate_foot.dxf
models/manufacturing-C5/parts/D01_Base.dxf
models/manufacturing-C5/parts/D02_Track_bed.dxf
models/manufacturing-C5/parts/D04_Bridge.dxf
models/manufacturing-C5/parts/D05_Stop_plate.dxf
models/manufacturing-C5/parts/D06_Stop_spacer_44.step
models/manufacturing-C5/parts/D10_Fixed_stripper.dxf
