palo399/SFuriel-Magnet-Press/models/concept-C3/Assembly_C3.png

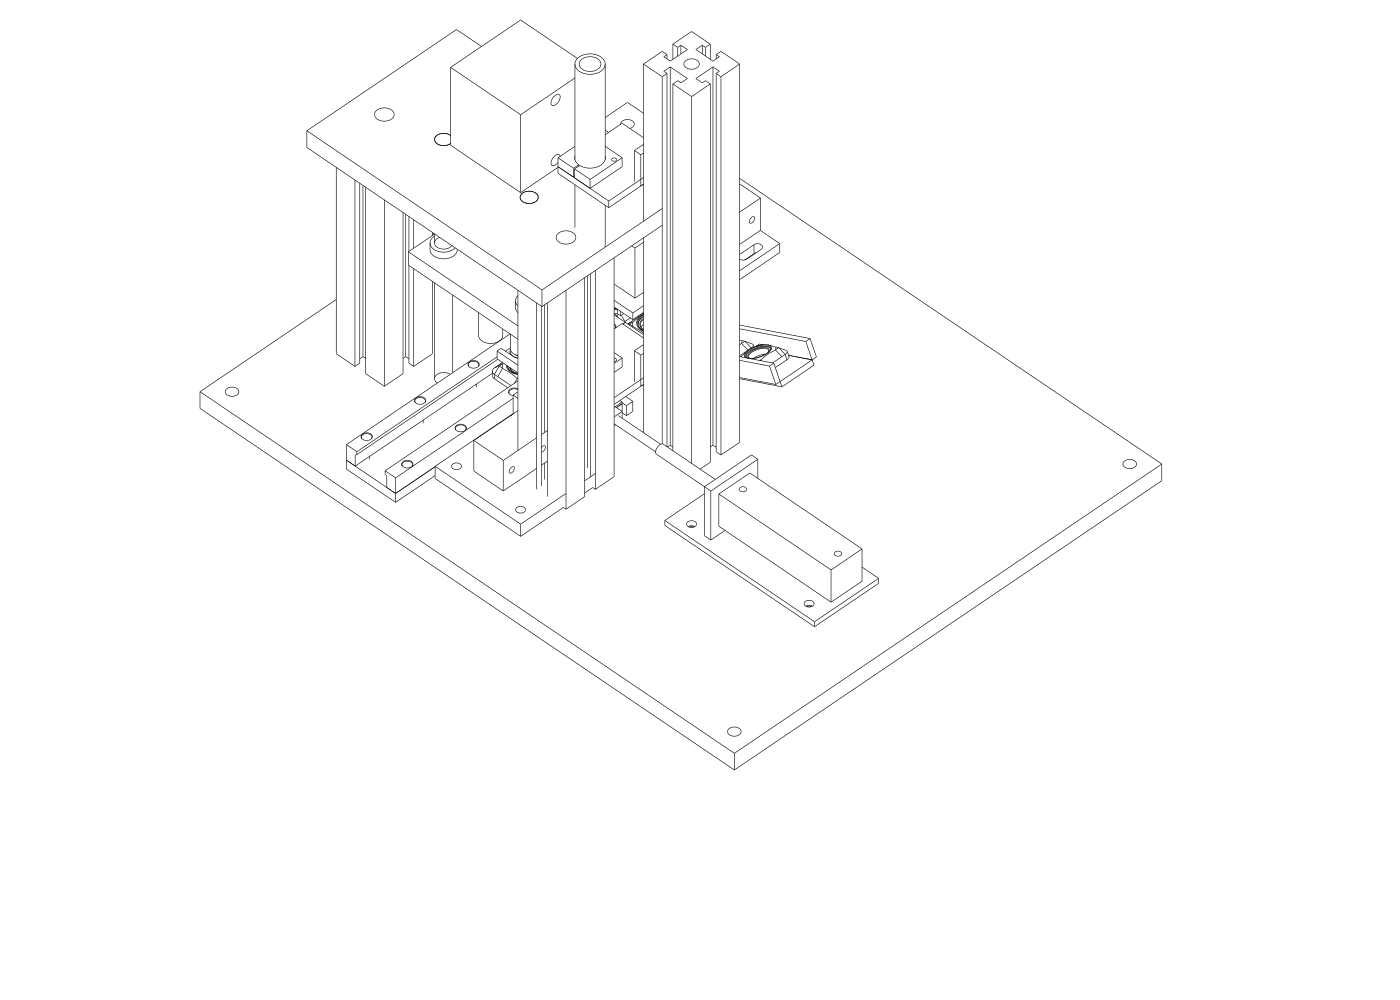
models/concept-C3/Assembly_C3.png
