palo399/SFuriel-Magnet-Press/models/concept-C4/Assembly_C4.png

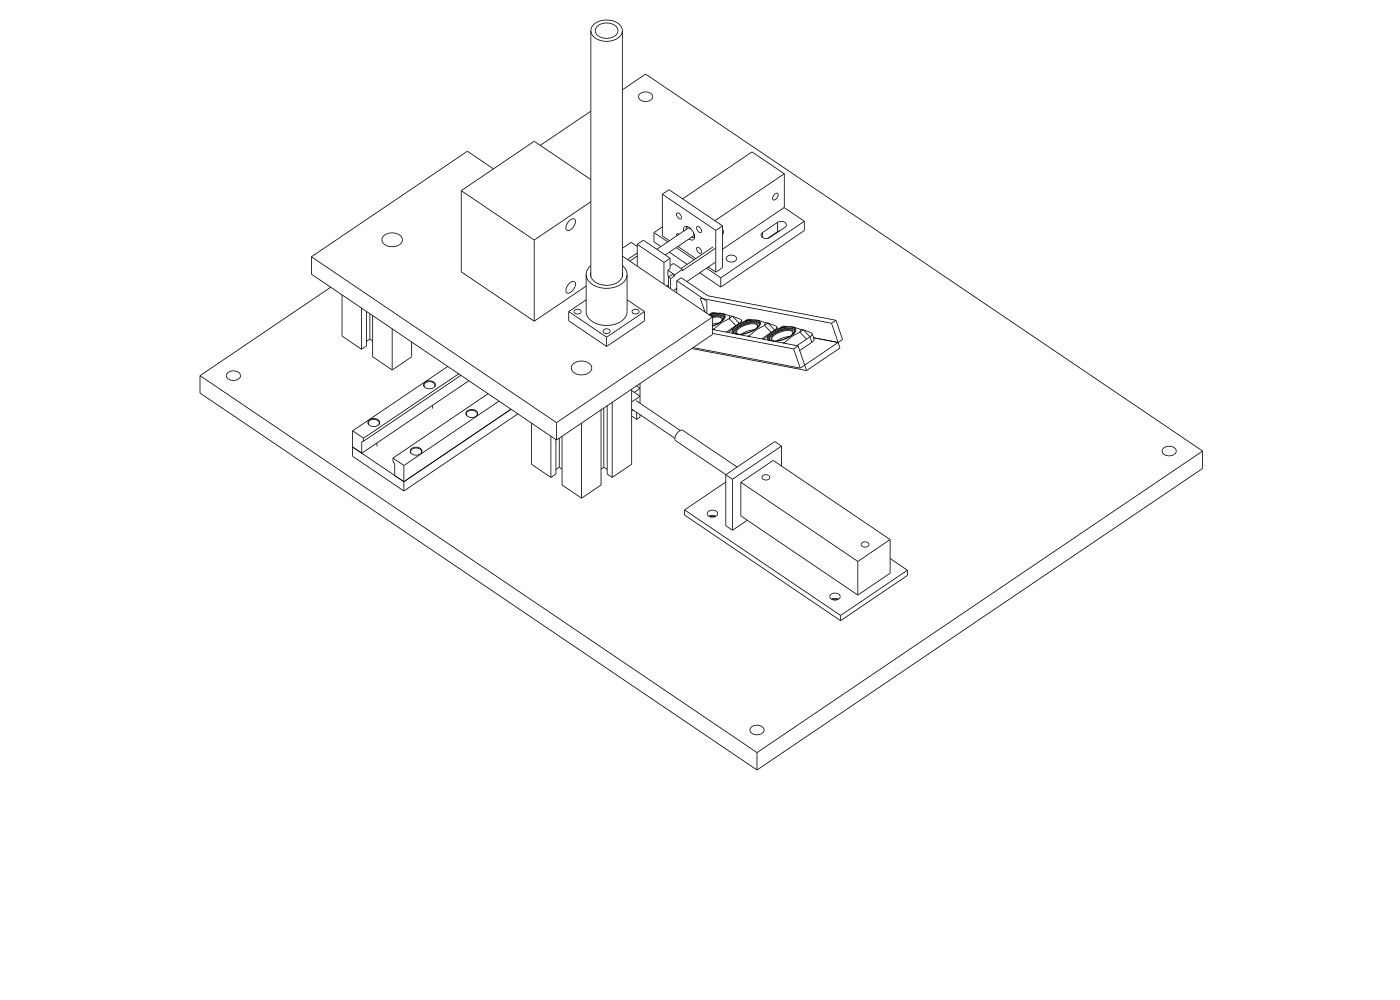
models/concept-C4/Assembly_C4.png
