palo399/SFuriel-Magnet-Press/(commit log)

2026-10-31 Add initial magnet press STEP concept and parametric source
    [Rohovnik magnet.stp, Rohovnik_magnet_press_V1.step]
2026-10-31 Add three magnet feeder STEP concepts and comparison previews
    [A_linear.step, B_rotary.step, C_fork.step]
2026-10-31 Revise C concept with open exit, bent inlet, separator and bottom plunger
    [C_fork.step]
2026-10-31 Detail C3 press layout with plate holes, Festo ADN mounts and Bosch profile frame
    [BOM.csv, Holes.csv, Left_through_retaining_rail.step, P01_Base.dxf, P01_Base.step, P02_Track_bed.dxf, P02_Track_bed.step, P03_Top_bridge.dxf]
2026-10-31 Simplify C4 to three ADN cylinders, direct press and passive feed separation
    [BOM_C4.csv, C4_Base_plate.step, C4_Bridge.step, Fixed_magnet_stripper.step, Linked_pusher_and_inlet_shutter.step, Mounting_holes_C4.csv, Rohovnik_press_C4_simple.step, Short_coaxial_press_tool.step]
2026-10-31 Develop C5 prototype drawings, actual KIPP plunger and press travel stop
    [BOM.csv, D01_Base.dxf, D01_Base.step, D02_Track_bed.dxf, D02_Track_bed.step, D03_Plunger_block.step, D04_Bridge.dxf, D04_Bridge.step]
